srinisekaran/anthrolink/RF Detector/scripts/voltage_threshold.png

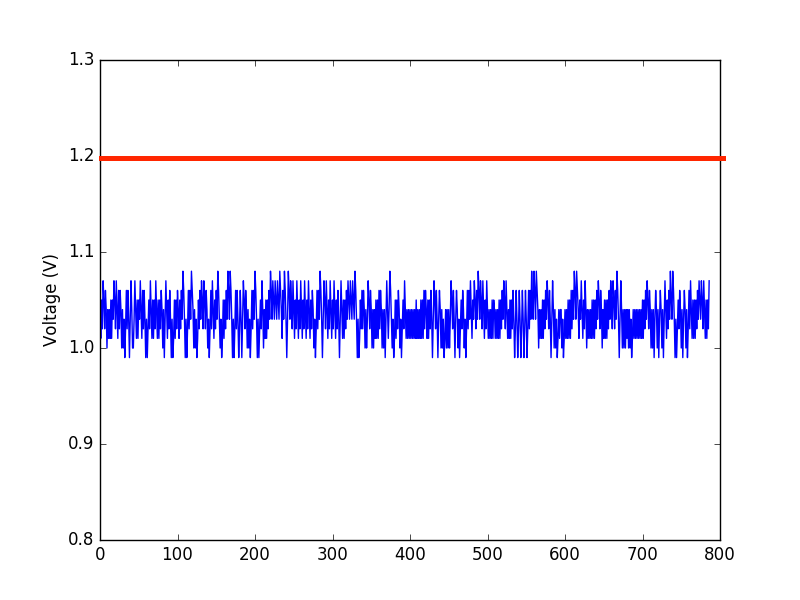
RF Detector/scripts/voltage_threshold.png
