srinisekaran/anthrolink/(commit log)

2017-03-31 Add switching algorithm
2017-04-15 Added Voltage Check Function
